simonhtet10/Haptic-Knob/media/torque_map_track.png

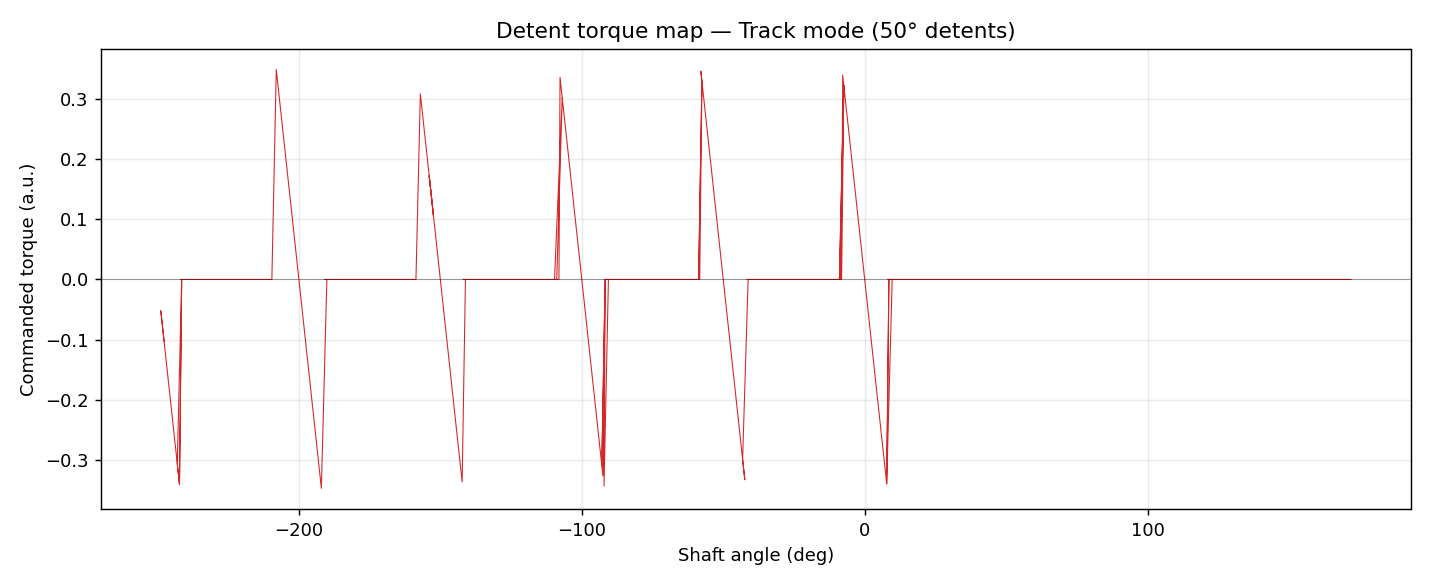
media/torque_map_track.png
