simonhtet10/Haptic-Knob/media/torque_map_volume.png

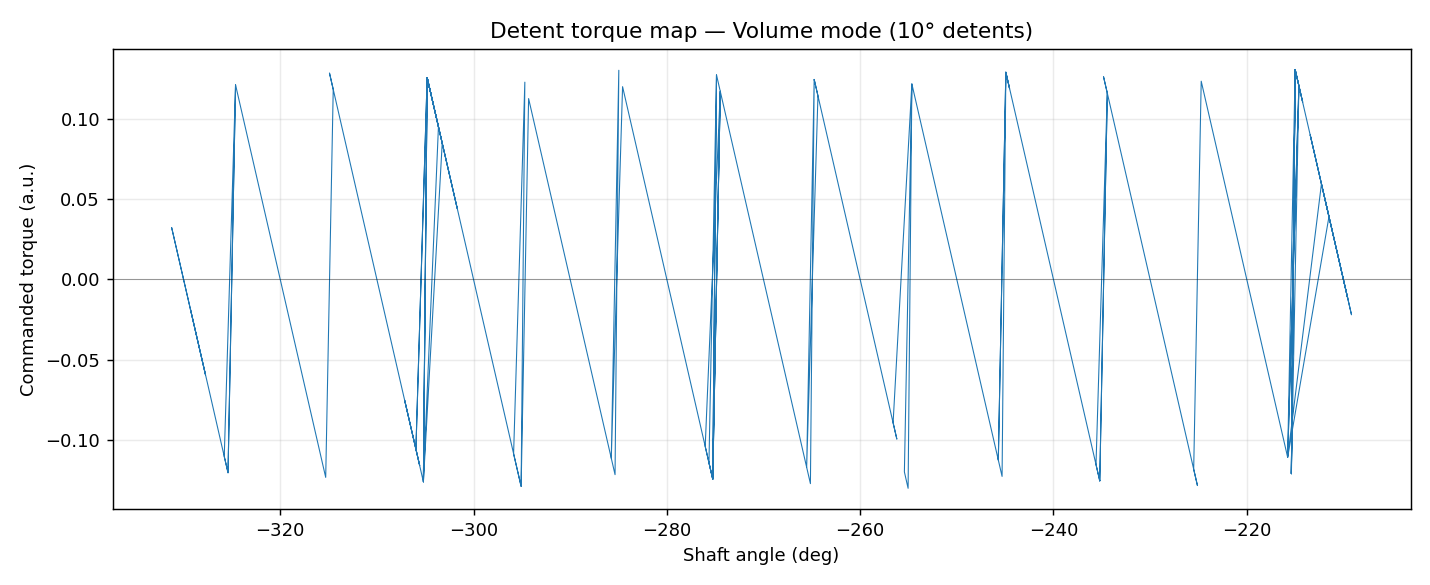
media/torque_map_volume.png
